Engr-Akbar-Shah/Wireless_debugger_techchore/docs/README.md

# Documents

| File | What |
| --- | --- |
| `test-report-2026-10-30.md` | Current test report: setup, method, results per requirement, acceptance tests, limitations |
| `client-requirements-status.md` | Full development and qualification log (links point to evidence files kept in the original workspace) |
| `pico-client-demo-guide.md` / `.docx` | Demo guide, 28 Oct version (predates auto bootloader: the `release` step is no longer needed) |
| `pico-client-testing-report.md` / `.docx` | Earlier testing report, 28 Oct (historical) |
| `report-assets/` | Data-path and setup images used by the guides |

Firmware is in the `siw917-ap`, `siw917-station`, `pico` and `stm32-fixture` branches; scripts and their run guide in `scripts`.
